djeZo888/WirelessSPDSystem/docs/flashing.md

# Configure and flash

## Tools and dependencies

Install [Arduino CLI](https://arduino.github.io/arduino-cli/installation/) and
Python 3.9+, plus Git. Clone this repository and run commands from its root.
The setup tool installs pinned dependencies into ignored `.arduino/`; it leaves
your usual Arduino installation separate. On Apple Silicon, the DxCore AVR tools
may need Rosetta 2.

| Target | Core | Libraries |
| --- | --- | --- |
| `acdc`, `battery` | DxCore 1.6.2 | RadioLib 7.8.1; pinned usha256 |
| `server` | ESP32 3.3.12 | RadioLib 7.8.1; GFX Library for Arduino 1.6.9; PubSubClient 2.8 |

Use `python3 tools/firmware.py setup acdc` (or `battery` / `server`).
The two beacons share dependencies, so one beacon setup is sufficient.
usha256 is fetched locally at an exact commit; see its
[licensing provenance](../firmware/beacons/third-party/usha256.md).

## Configure a beacon

Copy `config.example.h` to `config.h` inside the selected sketch folder:

```sh
cp firmware/beacons/acdc_avr128da32/config.example.h firmware/beacons/acdc_avr128da32/config.h
# For battery hardware use firmware/beacons/battery_avr128db32 instead.
```

Edit the local file's **per-server** section: set `WSPD_SHARED_SECRET`,
`WSPD_LORA_FREQ_MHZ` and `WSPD_LORA_SF` to the home's shared settings. Then set
the **per-SPD** section: a unique `WSPD_BEACON_ID` (10–127 in production),
`WSPD_LORA_TX_DBM` and the initial nonce if migrating an existing device.
Leave `WSPD_PREPRODUCTION=0` for deployment; set it to `1` only during testing
for randomized 20–40 second reports. Production timing is 300–600 seconds on
AC-DC hardware and 500–600 seconds on battery hardware. The first regular
report uses the existing 5 second startup delay in either mode.
Generate one nonzero random four-byte key for the home and repeat it in each
receiver registration. For example,
`python3 -c 'import secrets; print("0x%08XUL" % (secrets.randbelow(0xFFFFFFFF)+1))'`.
The example key is zero and compilation rejects it. Every field's limits are in
the config comments and the [configuration reference](radio-configuration.md).

**Programming connection:** use Microchip PICkit 4 in AVR/UPDI mode. Keep the AC
input disconnected; program the board from an isolated regulated 3.3 V supply
that can power the radio. Leave PICkit target power disabled (its supply is
limited to 50 mA). Connect by signal, checking the actual PCB header orientation:

| PICkit 4 pin | Board signal |
| ---: | --- |
| 1 | RESET / PF6 |
| 2 | VCC / target voltage sense |
| 3 | GND |
| 4 | Dedicated UPDI |

Both supplied schematics label the PCB header **1 RESET, 2 VCC, 3 GND, 4 UPDI**;
consult [hardware pin maps](../hardware/README.md) and verify the physical orientation.
PICkit pins 5–8 are unused. No serial
port is required. Fit the intended LoRa antenna before running the firmware.

```sh
python3 tools/firmware.py build acdc
python3 tools/firmware.py flash acdc
# Substitute battery for the battery-powered board.
```

The script selects no-bootloader AVR128DA32 at **4 MHz internal clock** for AC-DC
hardware, or AVR128DB32 at **24 MHz internal clock** for battery hardware. Both
use TCB2 millis and RESET enabled; DB builds enable MVIO. Exact options are in each
`build-options.json`. Upload writes flash with AVRDUDE verification and the
DxCore upload recipe's fuse settings. Inspect existing BOD/watchdog/fuse state
on the first target; these compile settings do not qualify battery clock/voltage
behavior. Avoid casual **Burn Bootloader**, which can erase the chip.

Both beacon builds are firmware 1 with persistent nonces. The CLI sets and
verifies EESAVE before flash erase and continuous active BOD at 1.9 V before
upload (battery BOD is sampled at 32 Hz in sleep). Manual IDE/programmer uploads
must establish these fuses before erasing. Keep EEPROM intact on future updates.
For an ID previously received with RAM-only firmware, set `WSPD_NONCE_START`
above its last received nonce when installing on blank EEPROM. See the
[journal, migration and power-loss checks](nonce-storage.md).

## Configure and flash the server

Use the **LILYGO T Connect Pro V1.0 with 868 MHz SX1262**, not the 433 MHz model.

```sh
python3 tools/firmware.py setup server
cp firmware/servers/tconnectpro_868/config.example.h firmware/servers/tconnectpro_868/config.h
```

Edit **only `config.h`**, leaving the `.ino` unchanged: set `CONFIGURED=true`, the
AP password, optional Wi-Fi credentials, and `SPD_CONFIGS` entries with matching
beacon IDs/keys and readable names.
Up to 127 wireless beacons plus one local contact can be configured. The LCD
advances through eight-row pages at `DISPLAY_PAGE_SECONDS` (**5** by default,
**1–3600** allowed); eight or fewer stay on one page. The dashboard and a single
`GET /api/v1/get` request always include the full list. Set `LORA_FREQ_MHZ` and
`LORA_SF` to match the home's beacons. The other modem parameters are fixed in
the sketches and absent from config files.
Leave `SPD_LOCAL_ID=-1`
unless using the optional isolated local dry contact.

When upgrading from channel-based beacon examples, replace
`WSPD_LORA_CHANNEL_ID` with `WSPD_LORA_FREQ_MHZ`; channel 1 was **865.3 MHz**.
For an existing receiver config, remove `LORA_BW_KHZ`, `LORA_CR`,
`LORA_SYNCWORD`, `LORA_PREAMBLE` and `LORA_CRC_ENABLED`; the sketch defines them.
Copy any new display and touch settings from the updated
`config.example.h` into your existing private `config.h`; keep your credentials
and beacon entries. Rebuild after configuration changes. The LCD identifies this
receiver release as **v0.2.5-tconnpro**; see its [changelog](../firmware/servers/tconnectpro_868/CHANGELOG.md).

Connect the ESP32 USB port with a data cable, find its port with
`arduino-cli board list`, then:

```sh
python3 tools/firmware.py build server
python3 tools/firmware.py flash server --port /dev/cu.usbmodemYOUR_PORT
```

Use the actual port (`COMn` on Windows). If upload cannot enter the bootloader,
hold BOOT, press/release RESET, then release BOOT and retry. Settings are ESP32S3
Dev Module, 16 MB flash, 3 MB APP / 9.9 MB FATFS partition, QIO 80 MHz, OPI PSRAM,
USB CDC enabled, 460800 upload; the script supplies the exact board options.

Open the IP shown on screen/Serial. Without a Wi-Fi connection, join the configured
fallback AP and open its displayed IP. Check the display and dashboard identify
each beacon correctly, then test OK/FAIL, temperature, battery voltage and alarms.
Power-cycle a persistent beacon and check that its next nonce is higher while
the receiver remains running. If migration or recovery requires clearing the
receiver's RAM history, restart the receiver; this also clears its live readings
and packet-loss history.

See the [server guide](../firmware/servers/tconnectpro_868/README.md) for the full
configuration reference, LCD paging, alarms, web API, RAM storage limits and
Arduino IDE settings.

## Arduino IDE alternative

Install the same pinned cores/libraries in Arduino IDE and add
`https://drazzy.com/package_drazzy.com_index.json` to Boards Manager URLs for DxCore.
Put the fetched usha256 folder in your IDE sketchbook's `libraries` directory.
Open the named `.ino`, add the adjacent local `config.h`, select the matching
options above and **Upload Using Programmer** for beacons (PICkit 4), or ordinary
USB upload for the server. The CLI's isolated packages are not automatically
visible to an IDE using a different sketchbook/data directory.

Local configuration, build images and build manifests contain secrets and are
ignored by Git. Flash checks reject changed source/configuration or modified
images; synthetic validation builds are never selected for upload.

Hardware/tool references: [PICkit 4 guide](https://ww1.microchip.com/downloads/aemDocuments/documents/DEV/ProductDocuments/UserGuides/MPLAB-PICkit-4-In-Circuit-Debugger-Users-Guide-DS50002751.pdf),
[DxCore programmer definitions](https://github.com/SpenceKonde/DxCore/blob/1.6.2/megaavr/programmers.txt),
[LILYGO board setup](https://github.com/Xinyuan-LilyGO/T-Connect-Pro).
