djeZo888/WirelessSPDSystem/integrations/home-assistant/guide.html

Save complete HTML guideDownload REST YAMLReceiver dashboard

# Home Assistant setup

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

## 1. Prepare the network and tools

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

python3 tools/firmware.py setup server

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

docker pull eclipse-mosquitto:2
docker image inspect eclipse-mosquitto:2 >/dev/null

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

## 2A. Broker on Home Assistant OS

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

## 2B. Separate broker for Container or legacy Core

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

In a new directory, create config/ and data/, then save this as config/mosquitto.conf:

listener 1883
allow_anonymous false
password_file /mosquitto/config/passwords
persistence true
persistence_location /mosquitto/data/
log_dest stdout

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

## 3. Add MQTT to Home Assistant

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

## 4. Configure and install the receiver image

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

## 5. Check discovered devices and add controls

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

## 6. Add fault and missing-monitoring notifications

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

## 7. Acceptance checks

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

## 8. Troubleshooting

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

## 9. REST alternative, including mute control

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

wireless_spd_api_url: "http://192.168.1.30/api/v1/get"
wireless_spd_base_url: "http://192.168.1.30"

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

## 10. Topic reference and retiring a device

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

## References and maintenance

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

This guide and all example code are stored in the receiver. External reference links are optional. Saved HTML remains readable without a network connection.
