djeZo888/WirelessSPDSystem/(list of files, drawings)

Other design files:
hardware/battery/schematic-revision.json
