djeZo888/WirelessSPDSystem/tests/check_server_api.py

#!/usr/bin/env python3
"""Exercise the production complete JSON response and HTTP routing with host I/O shims."""
import json
from pathlib import Path
import re
import shutil
import subprocess
import tempfile

ROOT = Path(__file__).resolve().parents[1]
SERVER = ROOT / "firmware/servers/tconnectpro_868"


def function(source, name):
    match = re.search(r"(?:static\s+)?(?:const char \*|String|bool|uint32_t|uint8_t|void)\s*" +
                      name + r"\([^;{]*\)\s*\{", source)
    if not match:
        raise RuntimeError(f"Cannot find firmware function: {name}")
    depth = 1
    tokens = re.finditer(r'"(?:\\.|[^"\\])*"|\'(?:\\.|[^\'\\])*\'|//[^\n]*|/\*.*?\*/|[{}]', source[match.end():], re.S)
    for token in tokens:
        if token.group() not in ("{", "}"):
            continue
        depth += 1 if token.group() == "{" else -1
        if not depth:
            return source[match.start():match.end() + token.end()]
    raise RuntimeError(f"Unclosed function: {name}")


SHIMS = r'''
#include "display_pages.h"
#include "version.h"
#include "config_types.h"
#include "ota_image.h"
#include "session_log.h"
#include "json_format.h"
#include <map>
#include <cassert>
#include <cstdio>
#include <cstring>
#include <iostream>
#include <string>
#include <type_traits>
#include <vector>
#define PROGMEM
// Arduino String's numeric constructors print numbers rather than characters.
struct String : std::string {
  String() = default;
  String(const char *s) : std::string(s) {}
  String(const std::string &s) : std::string(s) {}
  template<class T, typename std::enable_if<std::is_integral<T>::value, int>::type = 0>
  String(T v) : std::string(std::to_string(v)) {}
  String(double value, int decimals = 2) {
    char out[80]; snprintf(out, sizeof(out), "%.*f", decimals, value); assign(out);
  }
};
String operator+(const String &a, const String &b) { return String(std::string(a) + std::string(b)); }
String operator+(const String &a, const char *b) { return String(std::string(a) + b); }
String operator+(const char *a, const String &b) { return String(a + std::string(b)); }
constexpr size_t SPD_COUNT = WIRELESS_COUNT;
constexpr bool SPD_LOCAL_ENABLED = HAS_LOCAL;
constexpr size_t SPD_TOTAL_COUNT = SPD_COUNT + (SPD_LOCAL_ENABLED ? 1 : 0);
constexpr int16_t SPD_LOCAL_ID = SPD_LOCAL_ENABLED ? 0 : -1;
constexpr int8_t SPD_LOCAL_PIN = 15;
const char *SPD_LOCAL_FRIENDLYNAME = "Local <contact>";
SpdConfig SPD_CONFIGS[SPD_COUNT ? SPD_COUNT : 1];
constexpr size_t SPD_PAYLOAD_LEN = 20;
constexpr uint16_t PACKET_LOSS_WINDOW_SIZE = 1000;
constexpr uint32_t STALE_AFTER_SECONDS = 700;
constexpr bool LOW_BATTERY_WARNING_ENABLED = true;
constexpr float LOW_BATTERY_WARNING_V = 2.95f;
constexpr float LORA_FREQ_MHZ = 865.3f, LORA_BW_KHZ = 125;
constexpr uint8_t LORA_SF = 10;
constexpr uint8_t ALARM_NONE = 0, ALARM_LOW_BATTERY = 1, ALARM_SPD_FAIL = 2;
uint32_t nowMs = 1000000, bootMs = 0;
uint32_t totalValidPackets = 0, totalInvalidPackets = 0, totalOldNoncePackets = 0;
uint32_t totalAuthRejects = 0, totalUnconfiguredRejects = 0;
bool alarmMuted = false, screenDirty = false;
const char *gatewayId = "wspd-test";
struct OtaShim {
  unsigned setupCalls = 0;
  bool enabled() const { return false; }
  bool busy() const { return false; }
  size_t slotSize() const { return 3 * 1024 * 1024; }
  void setup() { ++setupCalls; }
} firmwareOta;
struct MqttShim {
  bool enabled() const { return false; }
  bool connected() const { return false; }
  void notifyMuteStateChanged() {}
} mqttBridge;
constexpr uint16_t BLACK = 0;
constexpr size_t CONTENT_LENGTH_UNKNOWN = size_t(-1);
WspdSessionLog sessionLog; WspdSessionLog::Record logRecords[8];
const char *sessionBootId = "test-boot"; bool sessionLogPsram = false;
void sessionLogf(const char *, ...) {}
constexpr int HTTP_GET = 0, HTTP_POST = 1;
SpdDisplayPages displayPages(SPD_TOTAL_COUNT, 5000UL);
uint32_t millis() { return nowMs; }
String ipString() { return "192.0.2.1"; }
String u64Hex(uint64_t value) {
  char out[19]; snprintf(out, sizeof(out), "0x%016llX", static_cast<unsigned long long>(value));
  return out;
}
struct ServerShim {
  struct Route { String path; int method; void (*handler)(); };
  std::vector<Route> routes;
  void (*notFound)() = nullptr;
  bool started = false, valueProvided = false;
  String value; std::map<String, String> query;
  unsigned sends = 0, noStoreHeaders = 0;
  unsigned headerCollections = 0, attachments = 0;
  String disposition;
  int status = 0;
  String contentType, body;
  void sendHeader(const char *name, const char *value) {
    if (String(name) == "Content-Disposition") { attachments++; disposition=value; return; }
    assert(String(name) == "Cache-Control" && String(value) == "no-store"); noStoreHeaders++;
  }
  void send(int code, const char *type, const String &data) {
    sends++; status = code; contentType = type; body = data;
  }
  void send_P(int code, const char *type, const char *data) { send(code, type, String(data)); }
  void collectHeaders(const char **names, size_t count) {
    assert(count == 2 && String(names[0]) == "Authorization" && String(names[1]) == "X-WSPD-Update");
    headerCollections++;
  }
  void on(const char *path, int method, void (*handler)()) { routes.push_back({path, method, handler}); }
  void onNotFound(void (*handler)()) { notFound = handler; }
  void begin() { started = true; }
  bool hasArg(const char *name) { return query.count(String(name)); }
  String arg(const char *name) { assert(hasArg(name)); return query[String(name)]; }
  void setContentLength(size_t length) { assert(length == CONTENT_LENGTH_UNKNOWN); }
  void sendContent(const String &data) { body += data; }
  void dispatch(const char *path, int method, const char *argument = nullptr) {
    assert(started && notFound);
    query.clear(); if (argument) query["value"] = argument;
    for (const auto &route : routes) {
      if (route.path == path && route.method == method) { route.handler(); return; }
    }
    notFound();
  }
} server;
void requestScreenRedraw() { screenDirty = true; }
void setRelay(bool) {}
struct SerialShim { void printf(const char *, ...) {} } Serial;
void bootLogf(uint16_t, const char *, ...) {}
'''


CHECKS = r'''
int main() {
  for (size_t i = 0; i < SPD_COUNT; i++) {
    SPD_CONFIGS[i] = {static_cast<uint8_t>(i + 1), "Remote \"rack\" <&>\n\t", 1};
    auto &s = spdStates[i];
    s.seen = (i % 4 != 0);
    s.statusCode = (i % 4 == 2 ? 0 : 1);
    s.lastSeenMs = nowMs - (i % 4 == 3 ? 701000 : 2000);
    s.hardwareVersion = 2; s.firmwareVersion = 0;
    s.batteryValid = true; s.batteryVoltageV = (i % 4 == 1 ? 2.8f : 3.2f);
    s.temperatureC = -5; s.rssiDbm = -70.0f; s.snrDb = 9.0f;
    s.nonceKnown = s.seen; s.nonce = i + 1;
    s.packetCount = s.seen ? 5 : 0; s.totalSkipped = s.seen ? 2 : 0;
    if (s.seen) { s.loss.addMany(true, 5); s.loss.addMany(false, 2); }
    strcpy(s.rawHex, "0000000000000000000000000000000000000000");
  }
  localSpd.seen = SPD_LOCAL_ENABLED; localSpd.statusCode = 1;
  assert(setupWebServer() && server.headerCollections == 1 && firmwareOta.setupCalls == 1);
  // Obsolete operations must follow the normal unknown-route path and cannot mutate state.
  const String original = buildApiJson();
  screenDirty = false;
  server.dispatch("/api/v1/reset_nonces", HTTP_POST);
  assert(server.status == 404 && server.body == "{\"error\":\"not_found\"}");
  assert(buildApiJson() == original && !screenDirty);
  // Both explicit values and the toggle form retain the actual mute route's behavior.
  for (const char *value : {"1", "0", static_cast<const char *>(nullptr)}) {
    screenDirty = false;
    const bool expected = value ? String(value) != "0" : !alarmMuted;
    server.dispatch("/api/v1/mute", HTTP_POST, value);
    assert(server.status == 200 && alarmMuted == expected && screenDirty);
    assert(server.body == String("{\"status\":\"ok\",\"alarm_muted\":") +
                          (expected ? "true}" : "false}"));
  }
  server.dispatch("/api/v1/mute", HTTP_POST, "0");
  assert(!alarmMuted && buildApiJson() == original);
  // A GET is one complete HTTP response even when another LCD page is active.
  displayPages.restart(0);
  String firstResponse;
  for (size_t page = 0; page < displayPages.pageCount(); page++) {
    const unsigned before = server.sends;
    server.dispatch("/api/v1/get", HTTP_GET);
    assert(server.sends == before + 1 && server.noStoreHeaders == server.sends);
    assert(server.status == 200 && server.contentType == "application/json; charset=utf-8");
    if (page == 0) firstResponse = server.body;
    else assert(server.body == firstResponse);
    std::cout << server.body << '\n';
    if (displayPages.pageCount() > 1)
      assert(displayPages.advance(static_cast<uint32_t>((page + 1) * 5000)));
  }
  assert(displayPages.pageIndex() == 0);
  server.dispatch("/ha-guide", HTTP_GET); assert(server.status==200 && server.body==HA_GUIDE_HTML);
  assert(server.contentType=="text/html; charset=utf-8");
  server.query["download"]="1"; handleHaGuide(); assert(server.disposition.find("home-assistant.html")!=String::npos);
  server.dispatch("/ha-rest.yaml", HTTP_GET); assert(server.status==200 && server.body==HA_REST_YAML && server.contentType=="text/yaml; charset=utf-8");
  assert(server.disposition.find("rest.yaml")!=String::npos && server.attachments==2);
  // Pretty response is plaintext and preserves the complete existing JSON data.
  server.query.clear(); server.query["pretty"] = "1"; handleApiGet();
  assert(server.contentType == "text/plain; charset=utf-8" && server.body.find('\n') != String::npos);
  std::cout << "PRETTY " << jsonEscape(server.body.c_str()) << '\n';
  sessionLog.begin(logRecords, 8);
  for (unsigned i = 1; i <= 12; ++i) sessionLog.append(1000ULL * i, i == 12 ? "Packet \"quoted\" \\ raw" : "Boot step");
  auto logs = [](const std::map<String, String> &query) { server.query = query; handleLogs(); assert(server.status == 200); std::cout << "LOG " << server.body << '\n'; };
  logs({{"tail", "1"}, {"limit", "3"}});
  logs({{"before", "10"}, {"limit", "3"}});
  logs({{"after", "0"}, {"limit", "3"}});
  sessionLog.syncClock(10000, 1800000000000ULL);
  logs({{"after", "9"}});
  logs({{"after", "18446744073709551615"}});
  logs({{"before", "0"}});
  for (auto query : {std::map<String, String>{{"limit", "101"}}, {{"limit", "0"}}, {{"after", "-1"}}, {{"before", "18446744073709551616"}}, {{"after", "1"}, {"before", "2"}}, {{"tail", "0"}}}) {
    server.query = query; handleLogs(); assert(server.status == 400 && server.body.find("query") != String::npos);
  }
}
'''



def verify_response(payload, wireless, local):
    expected_ids = ([0] if local else []) + list(range(1, wireless + 1))
    rows = payload["spds"]
    assert payload["gateway"]["server_version"] == "v0.2.4"
    assert payload["gateway"]["firmware_id"] == "v0.2.4-tconnpro"
    assert payload["gateway"]["gateway_id"] == "wspd-test"
    assert payload["gateway"]["mqtt"] == {"enabled": False, "connected": False}
    assert payload["gateway"]["ota"] == {
        "enabled": False, "busy": False, "slot_size": 3 * 1024 * 1024,
        "image_marker": "WirelessSPDSystem:tconnpro:ota-v1",
    }
    assert "nonce_resets" not in payload["gateway"]
    assert payload["summary"]["configured"] == wireless + local
    assert [row["spd_id"] for row in rows] == expected_ids
    assert len(rows) == len(expected_ids)
    for row in rows:
        if row["local"]:
            assert row["source"] == "local" and row["friendly_name"] == "Local <contact>"
            assert row["status"] == "OK" and row["hardware_version"] is None
            continue
        index = row["spd_id"] - 1
        mode = index % 4
        assert row["friendly_name"] == 'Remote "rack" <&>\n\t'
        assert row["status"] == ["UNKNOWN", "OK", "FAIL", "STALE"][mode]
        assert row["status_code"] == [None, 1, 0, None][mode]
        assert row["battery_low_alarm"] == (mode == 1)
        assert row["stale"] == (mode == 3)
        if mode != 0:
            assert row["hardware_version"] == 2 and row["firmware_version"] == 0
            assert row["temperature_c"] == -5 and row["packet_count"] == 5
            assert row["packet_loss_window_total"] == 7
            assert row["packet_loss_window_missed"] == 2
    statuses = [row["status"] for row in rows]
    summary = payload["summary"]
    assert summary["seen"] == sum(status != "UNKNOWN" for status in statuses)
    assert summary["ok"] == statuses.count("OK")
    assert summary["fail"] == statuses.count("FAIL")
    assert summary["unknown"] == statuses.count("UNKNOWN") + statuses.count("STALE")
    assert summary["stale"] == statuses.count("STALE")
    assert summary["low_battery"] == sum(row["battery_low_alarm"] for row in rows)


def main():
    compiler = shutil.which("c++")
    if not compiler:
        raise SystemExit("A host C++ compiler is required.")
    source = (SERVER / "tconnectpro_868.ino").read_text()
    config = (SERVER / "config.example.h").read_text()
    for removed in ("RESET_API_KEY", "X-API-Key-Reset", "resetApiAuthorized",
                    "handleResetNonces", "nonceResets", "nonce_resets", "reset_nonces"):
        assert removed not in source, f"Removed operation remains in firmware: {removed}"
        assert removed not in config, f"Removed operation remains in public configuration: {removed}"
    states = source[source.index("struct PacketLossWindow {"):source.index("volatile bool loraPacketFlag")]
    html = (SERVER / "web_ui.h").read_text()
    assert "reset_nonces" not in html and "X-API-Key-Reset" not in html
    body = SHIMS + states + '\n#include "web_ui.h"\n#include "ha_guide.h"\n'
    for name in ["ageSecondsFor", "isStale", "isBatteryLow", "isFresh", "isFreshFail",
                 "isFreshBatteryLow", "effectiveStatusText", "effectiveLocalStatusText",
                 "isLocalFreshFail", "currentAlarmKind", "alarmKindText", "jsonEscape",
                 "appendLocalSpdJson", "appendWirelessSpdJson", "buildApiJson", "sendJson",
                 "handleIndex", "handleHaGuide", "handleHaRest", "handleApiGet", "setAlarmMuted", "handleMute", "logDecimal", "handleLogs", "handleHealthz", "setupWebServer"]:
        body += function(source, name) + "\n"
    body += CHECKS
    variants = [(count, local) for count in (1, 8, 9, 17, 24, 127) for local in (0, 1)]
    variants.append((0, 1))
    with tempfile.TemporaryDirectory(prefix="wspd-api-") as temporary:
        work = Path(temporary)
        driver = work / "api.cpp"
        driver.write_text(body)
        for wireless, local in variants:
            binary = work / f"api-{wireless}-{local}"
            subprocess.run([compiler, "-std=c++11", "-O1", "-g",
                            "-fsanitize=address,undefined", "-fno-omit-frame-pointer",
                            "-I", str(SERVER), f"-DWIRELESS_COUNT={wireless}", f"-DHAS_LOCAL={local}",
                            str(driver), "-o", str(binary)], check=True)
            result = subprocess.run([str(binary)], check=True, capture_output=True, text=True)
            lines = result.stdout.splitlines()
            responses = [json.loads(line) for line in lines if not line.startswith(("LOG ", "PRETTY "))]
            pretty = [json.loads('"' + line[7:] + '"') for line in lines if line.startswith("PRETTY ")]
            assert len(pretty) == 1 and json.loads(pretty[0]) == responses[0]
            logs = [json.loads(line[4:]) for line in lines if line.startswith("LOG ")]
            assert len(logs) == 6
            assert [[e["seq"] for e in page["entries"]] for page in logs] == [[10,11,12],[7,8,9],[5,6,7],[10,11,12],[],[]]
            assert all(page["dropped"] == 4 and page["capacity"] == 8 and page["bytes"] == 4096 for page in logs)
            assert all(e["unix_ms"] is None for e in logs[0]["entries"])
            assert logs[3]["clock_synced"] and logs[3]["entries"][0]["unix_ms"] == 1800000000000
            assert logs[0]["entries"][-1]["message"] == 'Packet "quoted" \\ raw'
            assert logs[1]["has_more"] and logs[2]["has_more"] and not logs[0]["has_more"]
            assert len(responses) == (wireless + local + 7) // 8
            for response in responses:
                verify_response(response, wireless, local)
    print(f"PASS: {len(variants)} API configurations, up to 127 wireless SPDs plus local ID 0.")
    print("Verified paginated log cursors, overflow metadata, timestamps, and plaintext pretty JSON equivalence.")
    print("Verified one complete GET response on every LCD page, JSON telemetry/summary, integration diagnostics and mute routing.")
    print("Verified obsolete route returns 404 without changing state and removed configuration/header/UI are absent.")
    print("Host String and HTTP shims do not qualify physical Wi-Fi or maximum-device performance.")


if __name__ == "__main__":
    main()
