djeZo888/WirelessSPDSystem/tests/check_server_display.py

#!/usr/bin/env python3
"""Run the actual LCD renderer, alarm scan, touch handler, and loop with host I/O shims."""
from pathlib import Path
import re
import shutil
import subprocess
import tempfile

ROOT = Path(__file__).resolve().parents[1]
SERVER = ROOT / "firmware/servers/tconnectpro_868"


def function(source, name):
    match = re.search(r"(?:static\s+)?(?:void|uint8_t|bool)\s+" + name +
                      r"\([^;{]*\)\s*\{", source)
    if not match:
        raise RuntimeError(f"Cannot find firmware function: {name}")
    at, depth = match.end(), 1
    while depth:
        depth += (source[at] == "{") - (source[at] == "}")
        at += 1
    return source[match.start():at]


SHIMS = r'''
#include "display_pages.h"
#include "version.h"
#include "config_types.h"
#include <algorithm>
#include <cassert>
#include <cstdarg>
#include <cstdio>
#include <cstring>
#include <string>
#include <vector>
using String = std::string;
constexpr size_t SPD_TOTAL_COUNT = TOTAL_ROWS;
constexpr bool SPD_LOCAL_ENABLED = HAS_LOCAL;
constexpr size_t SPD_COUNT = SPD_TOTAL_COUNT - (SPD_LOCAL_ENABLED ? 1 : 0);
constexpr int16_t SPD_LOCAL_ID = SPD_LOCAL_ENABLED ? 0 : -1;
constexpr int8_t SPD_LOCAL_PIN = 15;
const char *SPD_LOCAL_FRIENDLYNAME = "Local contact";
constexpr float LORA_FREQ_MHZ = 865.3f;
constexpr uint8_t LORA_SF = 10;
constexpr uint16_t BLACK = 0, WHITE = 1, RED = 2, DARKGREEN = 3;
constexpr uint8_t ALARM_NONE = 0, ALARM_LOW_BATTERY = 1, ALARM_SPD_FAIL = 2;
constexpr uint8_t RELAY_1 = 8, RELAY_INACTIVE_LEVEL = 1;
constexpr int16_t MUTE_BTN_X = 388, MUTE_BTN_Y = 194, MUTE_BTN_W = 92, MUTE_BTN_H = 24;
constexpr uint32_t TOUCH_DEBOUNCE_MS = 350UL, TOUCH_RELEASE_STABLE_MS = 160UL;
constexpr uint32_t DISPLAY_PERIODIC_REFRESH_MS = 60000UL;
constexpr uint16_t DISPLAY_PAGE_SECONDS = PAGE_SECONDS;
constexpr uint32_t PAGE_MS = uint32_t(DISPLAY_PAGE_SECONDS) * 1000UL;
struct SpdState {
  bool seen = false, fresh = false, batteryLow = false, batteryValid = false;
  uint8_t statusCode = 1, hardwareVersion = 1;
  float batteryVoltageV = 3.2f, rssiDbm = -70, snrDb = 9;
};
SpdConfig SPD_CONFIGS[SPD_COUNT ? SPD_COUNT : 1];
SpdState spdStates[SPD_COUNT ? SPD_COUNT : 1];
bool localFail = false;
bool screenFlashRed = false, screenDirty = true, alarmMuted = false;
uint8_t bootLineIndex = 0;
uint32_t nowMs = 0, lastScreenDrawMs = 0, lastFlashToggleMs = 0;
bool touchWasDown = false, touchSampleAvailable = false, touchSampleDown = false;
uint32_t lastTouchActionMs = 0, lastTouchDownSampleMs = 0;
int16_t touchSampleX = 0, touchSampleY = 0;
SpdDisplayPages displayPages(SPD_TOTAL_COUNT, PAGE_MS);
uint32_t millis() { return nowMs; }
bool isLocalFreshFail() { return SPD_LOCAL_ENABLED && localFail; }
bool isLocalFreshOk() { return SPD_LOCAL_ENABLED && !localFail; }
bool isFresh(const SpdState &s) { return s.seen && s.fresh; }
bool isFreshFail(const SpdState &s) { return isFresh(s) && s.statusCode == 0; }
bool isFreshBatteryLow(const SpdState &s) { return isFresh(s) && s.batteryLow; }
const char *effectiveLocalStatusText() { return localFail ? "FAIL" : "OK"; }
const char *effectiveStatusText(const SpdState &s) {
  return !s.seen ? "UNKNOWN" : (!s.fresh ? "STALE" : (s.statusCode ? "OK" : "FAIL"));
}
String ipString() { return "192.0.2.1"; }
String lossText(const SpdState &s) { return s.seen ? "100%" : "-"; }
String ageText(const SpdState &s) { return s.seen ? "1193h" : "never"; }
uint16_t colorLightRed() { return 4; }
uint16_t colorLightGreen() { return 5; }
uint16_t colorLightOrange() { return 6; }
struct Printed { int16_t x, y; String text; };
struct Graphics {
  int16_t x = 0, y = 0;
  uint16_t background = WHITE;
  std::vector<Printed> printed;
  int16_t width() { return 480; }
  void fillScreen(uint16_t color) { background = color; printed.clear(); }
  void setTextSize(int) {}
  void setTextColor(uint16_t) {}
  void setCursor(int16_t a, int16_t b) { x = a; y = b; }
  void drawLine(int16_t, int16_t, int16_t, int16_t, uint16_t) {}
  void fillRect(int16_t, int16_t, int16_t, int16_t, uint16_t) {}
  void print(const String &s) { printed.push_back({x, y, s}); }
  void printf(const char *format, ...) {
    char result[256]; va_list args; va_start(args, format);
    vsnprintf(result, sizeof(result), format, args); va_end(args); print(result);
  }
} graphics;
Graphics *gfx = &graphics;
size_t buttonCount = 0, flushCount = 0;
void drawButton(int16_t x, int16_t y, int16_t w, int16_t h, const char *label) {
  assert(x == MUTE_BTN_X && y == MUTE_BTN_Y && w == MUTE_BTN_W && h == MUTE_BTN_H);
  assert(strcmp(label, alarmMuted ? "UNMUTE" : "MUTE") == 0);
  buttonCount++;
}
void flushDisplay() { flushCount++; }
void requestScreenRedraw() { screenDirty = true; }
void setAlarmMuted(bool muted, const char *) { alarmMuted = muted; requestScreenRedraw(); }
void digitalWrite(int, int) {}
struct SerialShim { void printf(const char *, ...) {} } Serial;
struct ServerShim { void handleClient() {} } server;
struct OtaShim { void loop(uint32_t) {} bool busy() { return false; } } firmwareOta;
struct MqttShim { void loop(uint32_t, bool) {} } mqttBridge;
constexpr int WIFI_STA = 1, WL_CONNECTED = 1;
struct WifiShim { int getMode() { return WIFI_STA; } int status() { return WL_CONNECTED; } } WiFi;
void setRelay(bool) {}
void sessionLogf(const char *, ...) {}
void serviceSessionClock() {}
void serviceSessionEvents() {}
void serviceWiFi(uint32_t) {}
bool stationOnline() { return true; }
void handleLoRa() {}
void handleLocalSpd() {}
bool pollTouchLandscape(bool &down, int16_t &x, int16_t &y) {
  down = touchSampleDown; x = touchSampleX; y = touchSampleY;
  return touchSampleAvailable;
}
void handleAlarmRelay() {}
'''


CHECKS = r'''
std::vector<unsigned> renderedIds() {
  std::vector<unsigned> ids;
  for (const auto &item : graphics.printed) {
    if (item.x == 2 && item.y >= 45 && item.y <= 171) {
      assert(item.text.size() == 3);
      assert(item.y == 45 + 18 * static_cast<int>(ids.size()));
      ids.push_back(static_cast<unsigned>(std::stoul(item.text)));
    }
  }
  return ids;
}
bool textContains(const char *needle) {
  for (const auto &item : graphics.printed)
    if (item.text.find(needle) != String::npos) return true;
  return false;
}
void checkVersionLabel(int16_t x, int16_t y) {
  assert(strcmp(SERVER_FIRMWARE_ID, "v0.2.4-tconnpro") == 0);
  size_t labels = 0;
  for (const auto &item : graphics.printed) {
    if (item.text == SERVER_FIRMWARE_ID) {
      assert(item.x == x && item.y == y); labels++;
    }
  }
  assert(labels == 1);
}
void checkRenderer() {
  drawBootHeader();
  // The boot label shares the header line, with space reserved on the right.
  assert(textContains(SERVER_FIRMWARE_ID));
  displayPages.restart(100);
  std::vector<unsigned> allIds;
  const size_t expectedPages = (SPD_TOTAL_COUNT + 7) / 8;
  assert(displayPages.pageCount() == expectedPages);
  for (size_t page = 0; page < expectedPages; page++) {
    buttonCount = flushCount = 0;
    drawStatusTable();
    const auto ids = renderedIds();
    assert(ids.size() == (page + 1 < expectedPages ? 8 : SPD_TOTAL_COUNT - 8 * page));
    assert(buttonCount == 1 && flushCount == 1);
    assert(textContains("LOCAL") == (SPD_LOCAL_ENABLED && page == 0));
    assert(textContains("Page ") == (expectedPages > 1));
    if (SPD_TOTAL_COUNT == 19) {
      const char *footers[] = {"Page 1/3  SPDs 1-8/19", "Page 2/3  SPDs 9-16/19", "Page 3/3  SPDs 17-19/19"};
      assert(textContains(footers[page]));
    }
    checkVersionLabel(2, 211);
    allIds.insert(allIds.end(), ids.begin(), ids.end());
    if (expectedPages > 1) {
      nowMs = 100 + static_cast<uint32_t>(PAGE_MS * (page + 1));
      assert(displayPages.advance(nowMs));
    }
  }
  assert(displayPages.pageIndex() == 0);
  assert(allIds.size() == SPD_TOTAL_COUNT);
  size_t index = 0;
  if (SPD_LOCAL_ENABLED) assert(allIds[index++] == 0);
  for (size_t wireless = 1; wireless <= SPD_COUNT; wireless++)
    assert(allIds[index++] == wireless);
}
void checkTableGeometry(bool batteryExpected) {
  bool batteryHeader = false, rssiHeader = false, snrHeader = false;
  for (const auto &item : graphics.printed) {
    if (item.y == 30 && item.text == "BAT") batteryHeader = true;
    if (item.y == 30 && item.text == "RSSI dBm") rssiHeader = true;
    if (item.y == 30 && item.text == "SNR dB") snrHeader = true;
  }
  assert(batteryHeader == batteryExpected && rssiHeader && snrHeader);
  // The built-in size-1 GFX font occupies 6 by 8 pixels per ASCII character.
  // Exercise real emitted text, including the longest name/status/age and
  // telemetry values, so a header or value crossing its neighbour fails.
  for (int16_t y : {int16_t(30), int16_t(45), int16_t(63), int16_t(81),
                    int16_t(99), int16_t(117), int16_t(135), int16_t(153), int16_t(171)}) {
    std::vector<Printed> line;
    for (const auto &item : graphics.printed) if (item.y == y) line.push_back(item);
    std::sort(line.begin(), line.end(), [](const Printed &a, const Printed &b) { return a.x < b.x; });
    int16_t right = 0;
    for (const auto &item : line) {
      assert(item.x >= right && item.y + 8 <= 222);
      right = item.x + static_cast<int16_t>(item.text.size() * 6);
      assert(right <= 480);
    }
  }
}
void checkAllPageLayouts(bool batteryExpected) {
  displayPages.restart(0);
  for (size_t page = 0; page < displayPages.pageCount(); ++page) {
    drawStatusTable();
    checkTableGeometry(batteryExpected);
    assert(renderedIds().size() == displayPages.rowCount());
    if (displayPages.pageCount() > 1) assert(displayPages.advance((page + 1) * PAGE_MS));
  }
}
void checkBatteryLayouts() {
  localFail = false; screenFlashRed = false;
  for (size_t i = 0; i < SPD_COUNT; ++i) {
    SPD_CONFIGS[i].friendlyName = "Name uses 18 chars!";
    spdStates[i] = SpdState();
    spdStates[i].seen = spdStates[i].fresh = true;
    spdStates[i].batteryValid = true; // Voltage alone must not create BAT.
  }
  assert(!hasBatteryBeacon());
  checkAllPageLayouts(false); // All AC-DC; local-only also hides BAT.
  if (SPD_COUNT == 0) {
    spdStates[0].seen = true; spdStates[0].hardwareVersion = 2;
    assert(!hasBatteryBeacon()); // Unused storage is not a configured beacon.
    checkAllPageLayouts(false);
    return;
  }
  for (size_t i = 0; i < SPD_COUNT; ++i) {
    spdStates[i].seen = spdStates[i].fresh = false;
    spdStates[i].hardwareVersion = 2;
  }
  assert(!hasBatteryBeacon());
  checkAllPageLayouts(false); // Unknown hardware metadata cannot create BAT.
  auto &battery = spdStates[SPD_COUNT - 1];
  battery.seen = true; battery.batteryValid = false;
  assert(hasBatteryBeacon());
  checkAllPageLayouts(true); // A stale off-page battery beacon retains BAT.
  for (size_t i = 0; i < SPD_COUNT; ++i) {
    spdStates[i].seen = spdStates[i].fresh = true;
    spdStates[i].hardwareVersion = 1;
  }
  battery.hardwareVersion = 2;
  for (bool showBattery : {false, true}) {
    battery.hardwareVersion = showBattery ? 2 : 1;
    for (float rssi : {-140.0f, -99.7f, -1.0f, 0.0f, 20.0f}) {
      for (float snr : {-20.0f, -19.75f, -0.1f, 0.0f, 10.0f, 12.5f}) {
        for (size_t i = 0; i < SPD_COUNT; ++i) {
          spdStates[i].rssiDbm = rssi; spdStates[i].snrDb = snr;
          spdStates[i].batteryValid = (i % 2 == 0);
          spdStates[i].batteryVoltageV = 3.60f;
        }
        assert(hasBatteryBeacon() == showBattery);
        checkAllPageLayouts(showBattery);
      }
    }
  }
}
void checkTiming() {
  for (uint32_t interval : {2000UL, 5000UL, 10000UL}) {
    SpdDisplayPages pages(17, interval);
    pages.restart(100);
    assert(!pages.advance(100 + interval - 1) && pages.pageIndex() == 0);
    assert(pages.advance(100 + interval) && pages.pageIndex() == 1);
    assert(!pages.advance(100 + 2 * interval - 1) && pages.pageIndex() == 1);
    assert(pages.advance(100 + 2 * interval) && pages.pageIndex() == 2);
    assert(pages.rowCount() == 1);
    assert(pages.advance(100 + 3 * interval) && pages.pageIndex() == 0);
    const uint32_t started = UINT32_MAX - interval / 2;
    const uint32_t expires = started + interval;
    pages.restart(started);
    assert(!pages.advance(expires - 1));
    assert(pages.advance(expires) && pages.pageIndex() == 1);
    pages.restart(12000);
    assert(pages.pageIndex() == 0 && !pages.advance(12000 + interval - 1));
    for (size_t total : {size_t(0), size_t(1), size_t(8)}) {
      SpdDisplayPages single(total, interval);
      single.restart(0);
      assert(single.rowCount() == total);
      assert(!single.advance(interval) && !single.advance(UINT32_MAX));
      assert(single.pageIndex() == 0);
    }
  }
}
void checkLoopAndAlarm() {
  displayPages.restart(0); nowMs = PAGE_MS - 1; screenDirty = false;
  loop(); assert(displayPages.pageIndex() == 0);
  nowMs = PAGE_MS; loop();
  assert(displayPages.pageIndex() == (SPD_TOTAL_COUNT > 8 ? 1 : 0));
  if (SPD_TOTAL_COUNT > 8) {
    nowMs = 2 * PAGE_MS - 1; loop(); assert(displayPages.pageIndex() == 1);
    nowMs = 2 * PAGE_MS; loop();
    assert(displayPages.pageIndex() == (2 % displayPages.pageCount()));
  }
  if (SPD_TOTAL_COUNT > 8 && SPD_COUNT > 0) {
    displayPages.restart(nowMs);
    auto &offPage = spdStates[SPD_COUNT - 1];
    offPage.seen = offPage.fresh = offPage.batteryLow = true;
    assert(currentAlarmKind() == ALARM_LOW_BATTERY);
    offPage.statusCode = 0;
    assert(currentAlarmKind() == ALARM_SPD_FAIL);
    screenFlashRed = true; drawStatusTable();
    assert(graphics.background == colorLightRed() && textContains("SPD FAIL ALARM"));
    const auto ids = renderedIds();
    for (auto id : ids) assert(id != SPD_COUNT);
    offPage.fresh = false;
    assert(currentAlarmKind() == ALARM_NONE);
    screenFlashRed = false;
  }
  if (SPD_LOCAL_ENABLED) {
    localFail = true; assert(currentAlarmKind() == ALARM_SPD_FAIL); localFail = false;
  }
}
void touchSample(uint32_t now, bool down, int16_t x, int16_t y) {
  nowMs = now; touchSampleAvailable = true; touchSampleDown = down;
  touchSampleX = x; touchSampleY = y; handleTouch();
}
void checkMuteTouch() {
  alarmMuted = false; screenDirty = false;
  touchSample(1000, true, MUTE_BTN_X + 1, MUTE_BTN_Y + 1);
  assert(alarmMuted && screenDirty);
  screenDirty = false;
  touchSample(1100, true, MUTE_BTN_X + 1, MUTE_BTN_Y + 1);
  assert(alarmMuted && !screenDirty); // Holding a finger toggles only once.
  touchSample(1200, false, 0, 0);
  assert(touchWasDown); // A brief empty sample cannot rearm the button.
  touchSample(1210, true, MUTE_BTN_X + 1, MUTE_BTN_Y + 1);
  assert(alarmMuted && !screenDirty);
  touchSample(1370, false, 0, 0);
  assert(!touchWasDown);
  touchSample(1371, true, MUTE_BTN_X + 1, MUTE_BTN_Y + 1);
  assert(!alarmMuted && screenDirty);
  screenDirty = false;
  touchSample(1531, false, 0, 0);
  touchSample(1532, true, MUTE_BTN_X + 1, MUTE_BTN_Y + 1);
  assert(!alarmMuted && !screenDirty); // Debounce also applies to fresh presses.
  touchSample(1800, false, 0, 0);
  touchSample(1801, true, 320, 205);
  assert(!alarmMuted && !screenDirty); // The former left button area is inert.
  drawStatusTable(); assert(buttonCount > 0);
  checkVersionLabel(2, 211);
}
int main() {
  for (size_t i = 0; i < SPD_COUNT; i++) {
    SPD_CONFIGS[i] = {static_cast<uint8_t>(i + 1), "Wireless", 1};
    spdStates[i].seen = spdStates[i].fresh = true;
  }
  checkRenderer(); checkTiming(); checkLoopAndAlarm(); checkMuteTouch(); checkBatteryLayouts();
}
'''


def main():
    compiler = shutil.which("c++")
    if not compiler:
        raise SystemExit("A host C++ compiler is required.")
    source = (SERVER / "tconnectpro_868.ino").read_text()
    # Reuse production capacity assertions instead of duplicating their limits.
    assertions = re.findall(r"static_assert\((?:SPD_|DISPLAY_PAGE_SECONDS)[^;]+;", source)
    body = SHIMS + "\n" + "\n".join(assertions) + "\n"
    for name in ["currentAlarmKind", "pointInRect", "handleTouch", "drawBootHeader", "hasBatteryBeacon", "drawStatusTable", "loop"]:
        body += function(source, name) + "\n"
    body += CHECKS
    variants = [(rows, local, 5) for rows in (1, 8, 9, 16, 17, 19, 127) for local in (0, 1)]
    variants.append((128, 1, 5))
    variants += [(17, local, seconds) for local in (0, 1) for seconds in (2, 10)]
    with tempfile.TemporaryDirectory(prefix="wspd-display-") as temporary:
        work = Path(temporary)
        driver = work / "display.cpp"
        driver.write_text(body)
        for rows, local, seconds in variants:
            binary = work / f"display-{rows}-{local}-{seconds}"
            subprocess.run([compiler, "-std=c++11", "-O1", "-g",
                            "-fsanitize=address,undefined", "-fno-omit-frame-pointer",
                            "-I", str(SERVER), f"-DTOTAL_ROWS={rows}", f"-DHAS_LOCAL={local}",
                            f"-DPAGE_SECONDS={seconds}",
                            str(driver), "-o", str(binary)], check=True)
            subprocess.run([str(binary)], check=True)
        for rows, local, seconds in [(0, 0, 5), (128, 0, 5), (129, 1, 5), (17, 0, 0), (17, 0, 3601)]:
            result = subprocess.run([compiler, "-std=c++11", "-fsyntax-only", "-I", str(SERVER),
                                     f"-DTOTAL_ROWS={rows}", f"-DHAS_LOCAL={local}",
                                     f"-DPAGE_SECONDS={seconds}", str(driver)],
                                    capture_output=True, text=True)
            if result.returncode == 0 or "static assertion" not in result.stderr:
                raise SystemExit(f"Expected production assertion for {rows} rows, local={local}, interval={seconds}s")
    print(f"PASS: {len(variants)} LCD configurations; actual renderer, loop, alarm scan, and mute touch handler.")
    print("Verified adaptive BAT for AC-DC/mixed/stale/off-page/local/unseen rows, radio units and non-overlapping LCD text.")
    print("Verified complete rows, version footer, off-page alarms, configurable 2/5/10-second timing, rollover, and mute debounce.")
    print("Host graphics and telemetry shims do not qualify physical LCD, touch, relay, RF, or maximum-device performance.")


if __name__ == "__main__":
    main()
