djeZo888/WirelessSPDSystem/(commit log)

2026-10-09 Add sanitized beacon and receiver firmware with hardware and protocol guides
    [schematic-revision.json]
2026-10-09 Add verified hardware 1 Gerber download (#1)
2026-10-09 Update hardware documentation with recovered battery production files (#2)
    [schematic-revision.json]
2026-10-09 Persist beacon nonces across power loss on both hardware versions (#4)
2026-10-09 Remove obsolete receiver nonce reset from v0.1 (#6)
    [check_server_api.py, check_server_display.py, config.example.h, display_pages.h, tconnectpro_868.ino]
2026-10-12 Sleep AC-DC beacon MCU and radio between reports (#9)
    * Sleep AC-DC beacon MCU and radio between reports
    * Keep a green heartbeat and steady red fault LED during sleep
